maxsimmonds1337/SBS_hw/manufacturing/SBS_hw_schematic.pdf

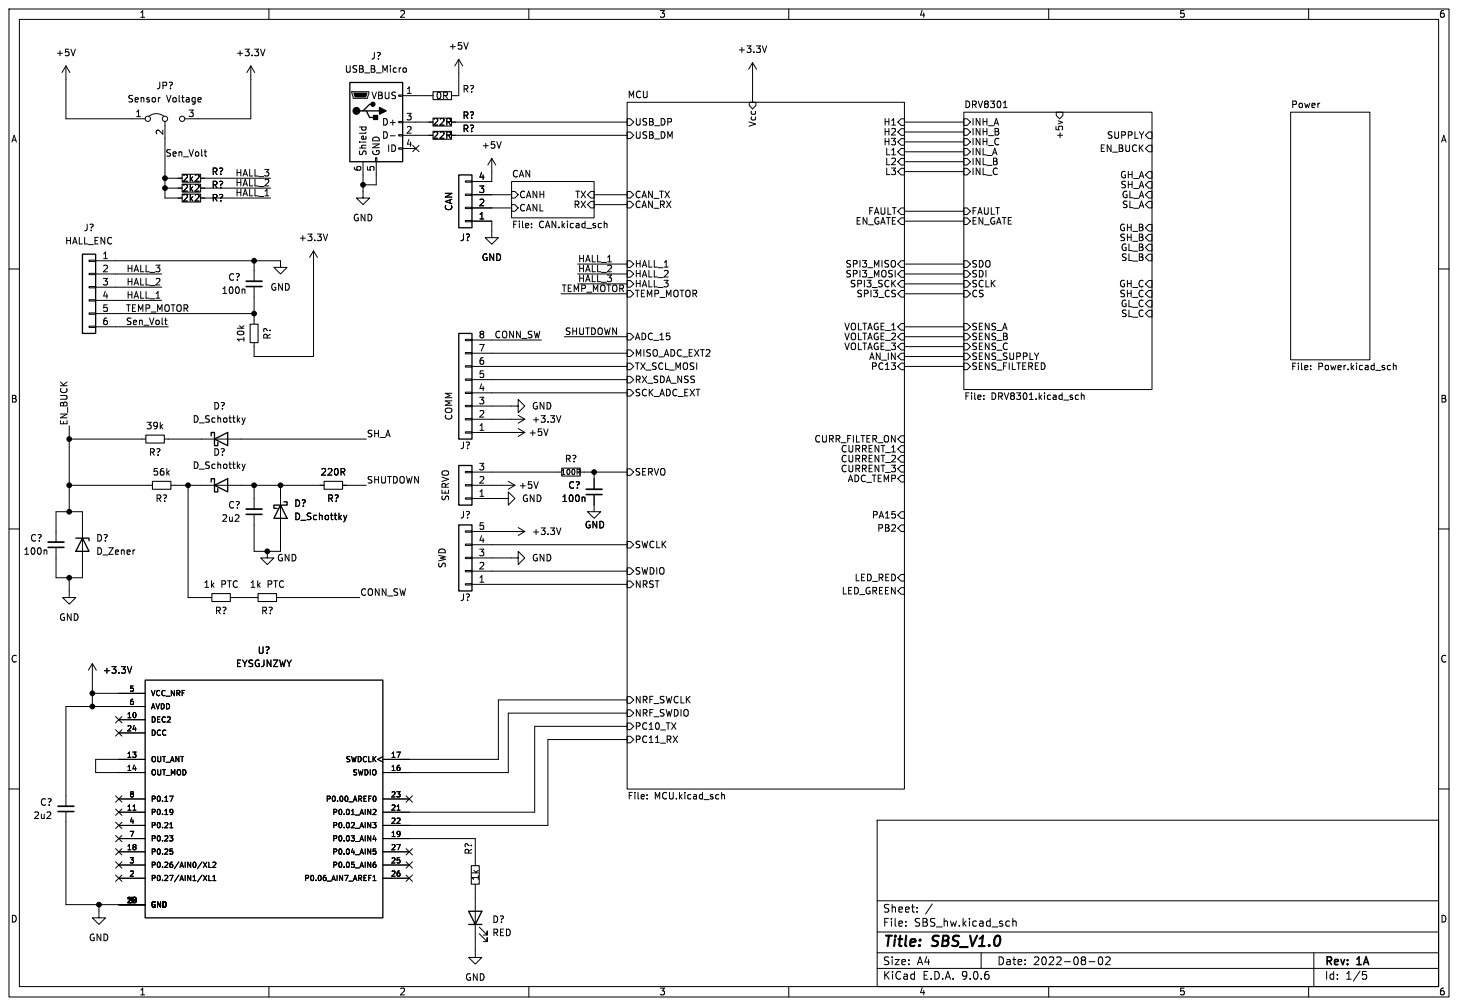
[picture p1: page 1]

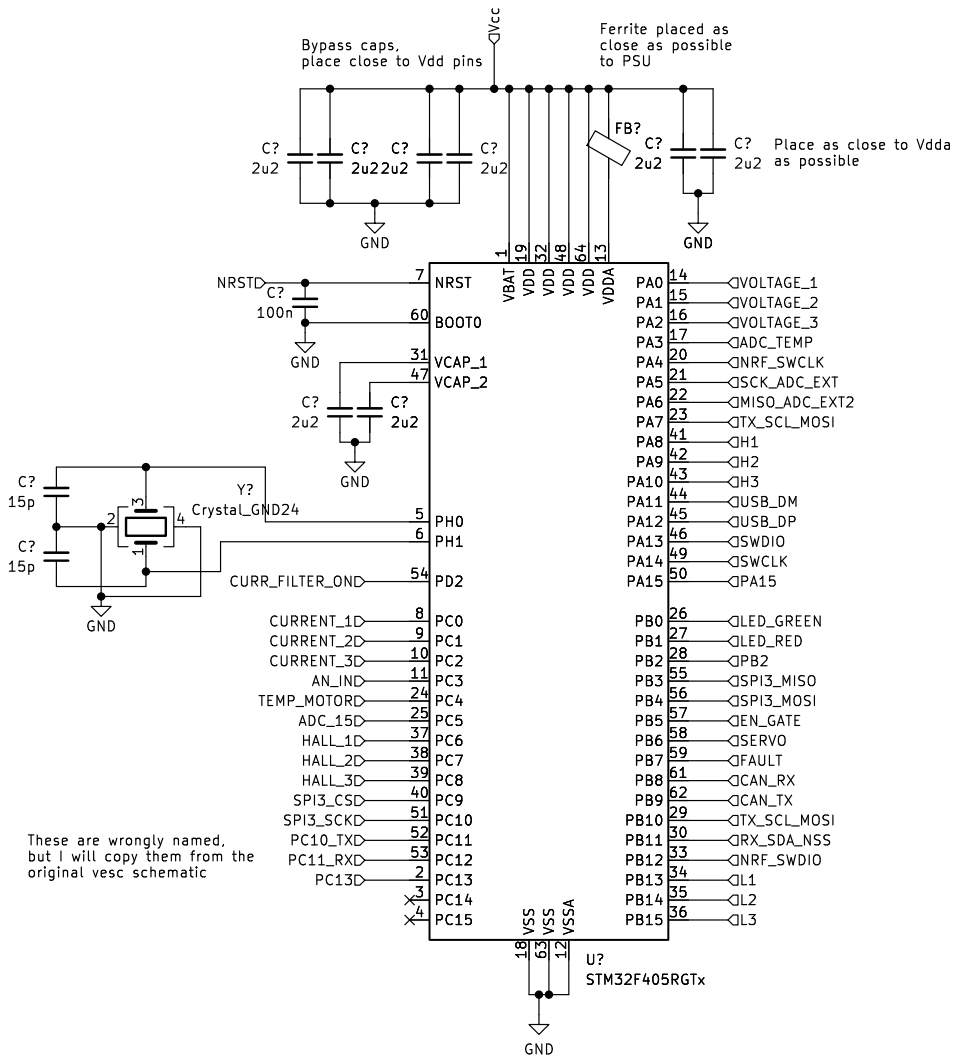
[picture p2: page 2]

Place as close to Vdda

These are wrongly named, but I will copy them from the

Id: 2/5 Title: File: MCU.kicad_sch Sheet: /MCU/

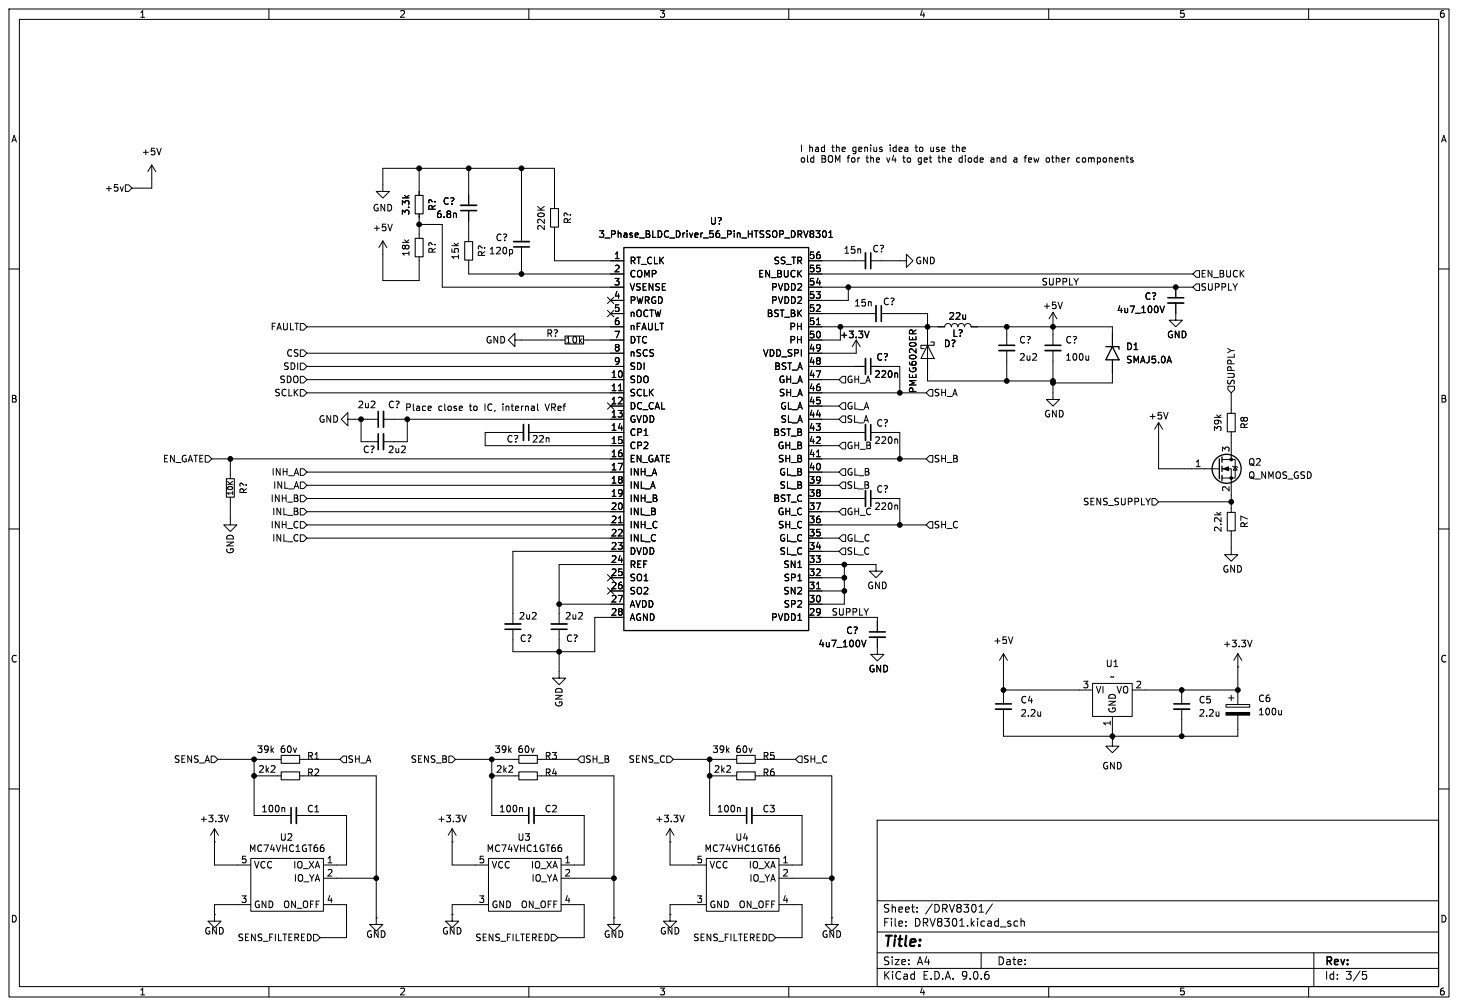
[picture p3: page 3]

I had the genius idea to use the

1 VO 2 U1~ GND GND GND GND

SUPPLY
Id: 3/5 Title: File: DRV8301.kicad_sch Sheet: /DRV8301/ C?

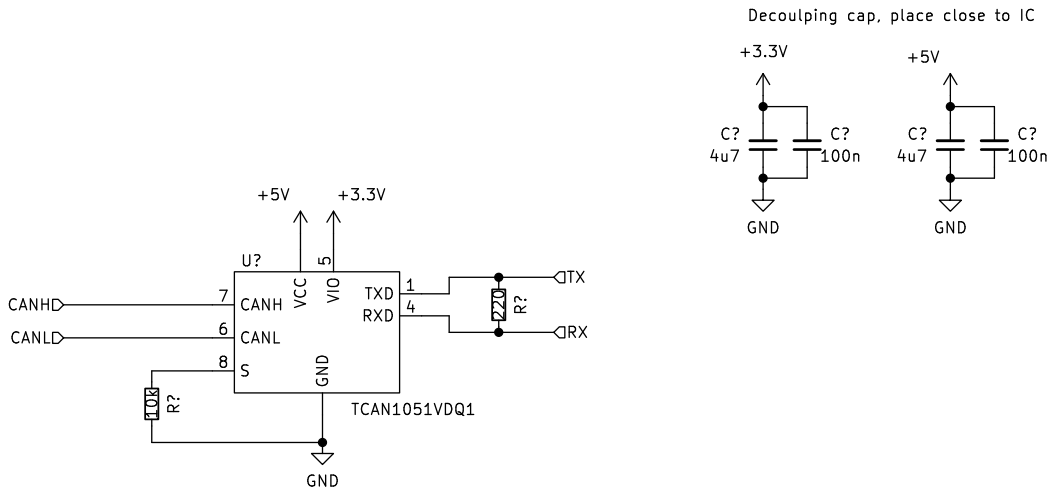
[picture p4: page 4]

Id: 4/5 Title: File: CAN.kicad_sch Sheet: /CAN/

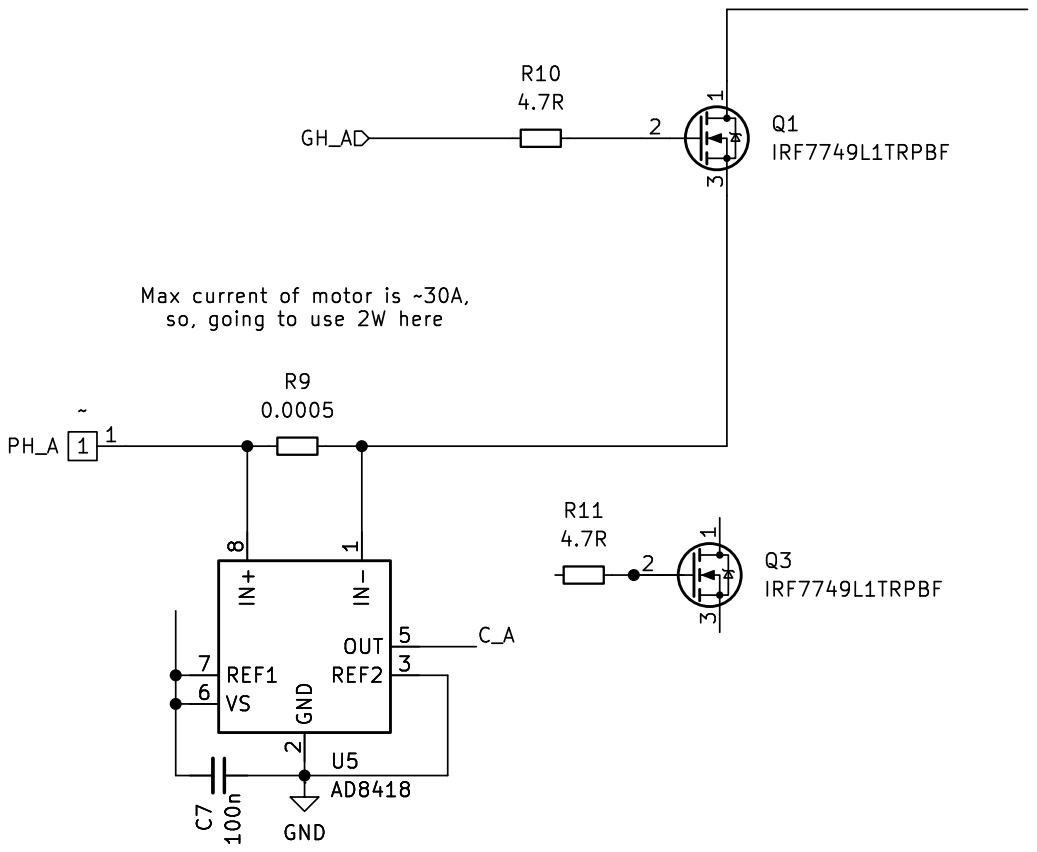
[picture p5: page 5]
