maxsimmonds1337/SBS_hw/simulation/ClosedLoopBuck_PDB.asc

A2: schmtinv; Vhigh=5
A3: and; Vhigh=5
A4: or; Vhigh=5
A6: schmtinv; Vhigh=5
A7: schmtinv; Vhigh=5
C1: cap; 400p
C2: cap; 1n
C3: cap; 10µ
C4: cap; 10µ
C6: cap; 4.55n
C7: cap; 3.18n
C8: cap; 3.18n
C: cap; 100µ; IC=0
D1: diode; 1N914
D2: diode; MMSD4148
L1: ind; 145µ; Ipk=3 Rser=0.09 Rpar=48000 Cpar=3.47p mfg="Gowanda" pn="GT10-105"
M2: nmos; BSC032NE2LS
Q2: pnp; 2N2907
R1: res; 5
R2: res; 2k
R7: res; 7k5
R8: res; 4k3
R9: res; 18.7k
R10: res; 10k
R11: res; 100k
R13: res; 27k
R14: res; 120k
R15: res; 1k
R16: res; 150k
R17: res; 1Meg
R: res; 100k
S1: sw; MYSW
U2: IR2110
U3: OP07
U4: LT1716
U5: NE555
V1: voltage; 12
V2: voltage; 5
V3: voltage; 1.8
V4: voltage; PULSE(5 0 3.5m 1n 1n 20m 40m)
Named nets: HS, 0, LIN, HIN, p5, Vcc, Vout, Vc, saw, Vpwm, Vsence, VS, load, LS
Gate Driver Board
.tran 100m
Dead Time Generator
Saw-Tooth Generator
Main Board Buck Converter
Compensator
PWM modulator
Bootstrap Capacitors
Voltage Sense
.model MYSW SW(Ron=1 Roff=1Meg Vt=.5 Vh=-.4)
R1
R2
C1
C2
