maxsimmonds1337/SBS_hw/design/BMI160.kicad_sch

## KiCad design design/BMI160.kicad_sch (2026-06-29, an earlier design)

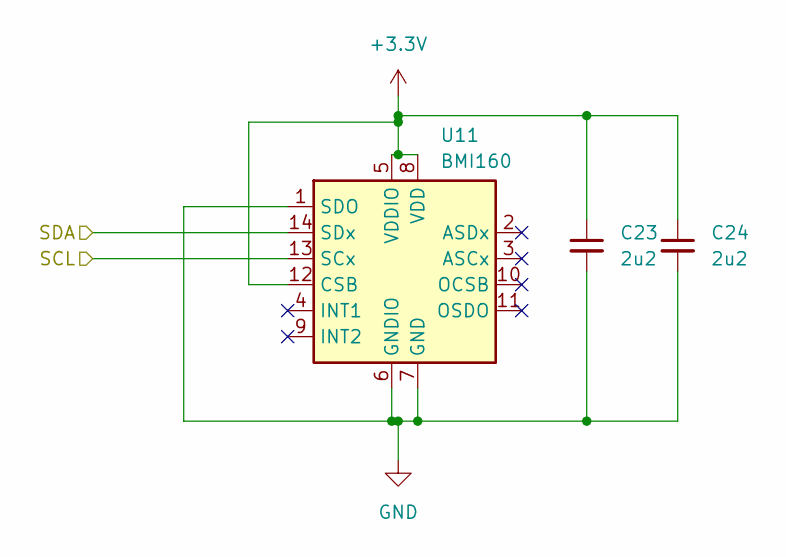
[picture p6: schematic BMI160.kicad_sch]

Parts:
C23, C24: 2u2
U11: BMI160; Bosch_LGA-14_3x2.5mm_P0.5mm

Connections:
+3.3V: C23.1, C24.1, U11.5 (VDDIO), U11.8 (VDD), U11.12 (CSB)
GND: C23.2, C24.2, U11.1 (SDO), U11.6 (GNDIO), U11.7 (GND)
SCL: U11.13 (SCx)
SDA: U11.14 (SDx)
