maxsimmonds1337/SBS_hw/design/Power.kicad_sch

## KiCad design design/Power.kicad_sch (2026-06-30, an earlier design)

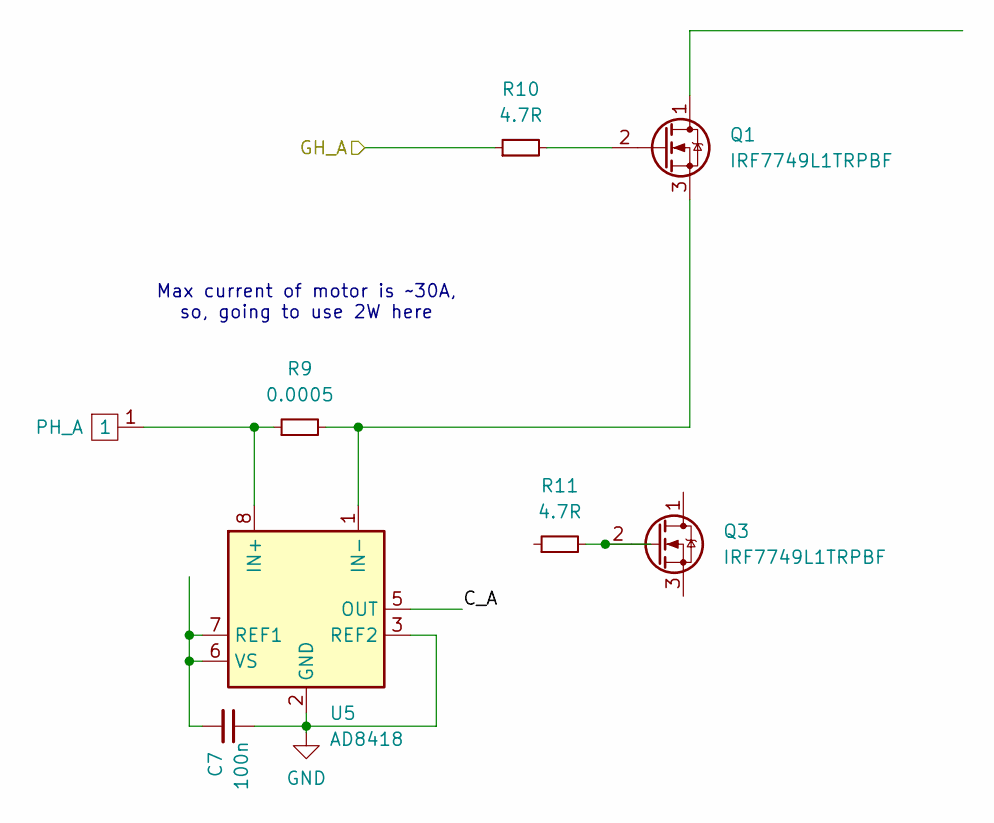
[picture p7: schematic Power.kicad_sch]

Parts:
C7: 100n; C_0603_1608Metric_Pad1.08x0.95mm_HandSolder
PH_A: (no value)
Q1, Q3: IRF7749L1TRPBF; DirectFET_L8
R9: 0.0005
R10, R11: 4.7R; R_0402_1005Metric
U5: AD8418

Connections:
C_A: U5.5 (OUT)
GH_A: R10.1
GND: C7.1, U5.2 (GND), U5.3 (REF2)
unnamed: C7.2, U5.6 (VS), U5.7 (REF1)
unnamed: PH_A.1, R9.1, U5.8 (IN+)
unnamed: Q1.2 (G), R10.2
unnamed: Q1.3 (S), R9.2, U5.1 (IN-)
unnamed: Q3.2 (G), R11.2

Notes on the sheet:
Max current of motor is ~30A, so, going to use 2W here
