maxsimmonds1337/SBS_hw/(commit log)

2021-09-21 added the kicad libs to the template, correctly, as a submodule
2022-08-19 push to work on another laptop
    [SBS_hw.kicad_pcb, SBS_hw.sch, TEOXXXX_boardname.sch]
2023-01-17 pushing from black laptop
    [DRV8301.kicad_sch, MCU.kicad_sch, SBS_hw.kicad_sch]
2023-01-18 reverted back to an older version (more stable) of kicad, so needed to start from an old copy
    [SBS_hw.kicad_sch, USB_OTG.kicad_sch]
2023-01-19 added some connectors:
    [SBS_hw.kicad_sch]
2025-02-21 updates to BLDC
    [CAN.kicad_sch, DRV8301.kicad_sch, MCU.kicad_sch, SBS_hw.kicad_sch]
2025-02-23 more BLDC updates
    [DRV8301.kicad_sch]
2026-06-25 add documentation, manufacturing outputs, and Power sheet WIP
    - Add requirements.md, schematic_review.md, battery_design.md,
    onewheel_system_design.md, vesc_firmware_notes.md
    - Add manufacturing/BOM.md (LCSC parts with costs) and schematic PDF
    - Add design/Power.kicad_sch (Phase A half-bridge WIP)
    - Update DRV8301, top-level and project KiCad files
    - Remove old 2023 backups and accidentally committed linkedin image
    [DRV8301.kicad_sch, Power.kicad_sch, SBS_hw.kicad_sch]
2026-06-25 rewrite schematic_review based on actual KiCad files
    Previous version was reviewed against the VESC 6 MK5 reference PDF,
    not the actual SBS_hw schematic. This version is based on direct
    review of the KiCad sheets and netlist analysis.
    Key findings added: incomplete Power sheet (phases B/C missing),
    CURR_FILTER_ON routing error, EN_BUCK undriven, DRV8301 footprint
    mismatch, BMI160 absent, Q2 unassigned, bootstrap diode voltage issue.
2026-06-26 substitute MC74VHC1GT66 → SN74LVC1G66DCKR on U2/U3/U4
    TI LVC1G66 DCK variant (LCSC C113518) is pin-compatible with the ON Semi
    part: both have pin2=B (signal), pin3=GND in SC-70-5. Update lib_id to
    74xGxx:74LVC1G66, set Value and assign Package_TO_SOT_SMD:SOT-353_SC-70-5
    footprint (was empty) on all three instances. BOM F6 flag resolved.
    [DRV8301.kicad_sch]
2026-06-27 finalised, ish, will have claude review
    [BMI160.kicad_sch, CAN.kicad_sch, DRV8301.kicad_sch, MCU.kicad_sch, Power.kicad_sch, SBS_hw.kicad_sch]
2026-06-27 Sheet 1 (SBS_hw.kicad_sch): assign footprints and part values
    - LEDs D2/D3/D4: footprint LED_SMD:LED_0603_1608Metric, values LED_RED/GREEN/BLUE
    - LED D?: footprint LED_SMD:LED_0603_1608Metric
    - Zener D?: value BZX84C3V6, footprint Diode_SMD:D_SOT-23
    - Schottky D? ×3: value 1N5819WS, footprint Diode_SMD:D_SOD-323
    - USB J?: footprint Connector_USB:USB_Micro-B_Molex_105017-0001
    - SERVO J?: footprint Connector_JST:JST_PH_S3B-PH-K 2mm horizontal
    - HALL_ENC J?: footprint Connector_JST:JST_PH_S6B-PH-K 2mm horizontal
    - COMM J?: footprint Connector_PinHeader_2.54mm 1x08
    - SWD J?: footprint Connector_PinHeader_1.27mm 1x05
    - CAN J?: footprint Connector_JST:JST_PH_S4B-PH-K 2mm horizontal
    - Sensor Volta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
    [SBS_hw.kicad_sch]
2026-06-27 Sheet 2 (MCU.kicad_sch): fix crystal; document BOOT0/PC13 and VDDA issues
    Crystal Y? (MC-007 RESOLVED):
    - Value: Crystal_GND24 → 8MHz
    - Footprint: → Crystal:Crystal_SMD_3225-4Pin_3.2x2.5mm
    (matches LCSC C5181477 SOSET 8MHz 20pF 10ppm per BOM.md)
    New issues found via direct coordinate analysis (both need KiCad wiring fixes):
    - MC-013: PC13 hierarchical label placed at BOOT0 pin (y=133.35) not PC13 GPIO (y=62.23)
    - MC-015: VDDA (pin 13) has no wire connection; needs +3.3V path and bypass caps
    [MCU.kicad_sch]
2026-06-27 Sheet 3 (DRV8301.kicad_sch): assign footprints, update parts, fix issues
    MC-002 partial: BST_A D? PMEG6020ER → DSS210 (100V, SOD-123F). BST_B/C still need placement in KiCad.
    MC-004 resolved: DRV8301 U? footprint set to Texas_HTSSOP-56_6.1x9.7mm_P0.65mm.
    MC-006 resolved: TC2117 U1 Value set (was ~), Footprint SOT-223-3_TabPin2.
    MC-008 resolved: Q2 SENS_SUPPLY assigned BSS138 / SOT-23.
    MC-014 partial: U2/U3/U4 Value → SN74LVC1G66DCKR, Footprint → SOT-353_SC-70-5 (lib_id kept compatible).
    Blank footprints filled in: C1/C2/C3 (100n 0603), C4/C5 (2.2u 0805), C6 (100u elec), R1-R6 (0603), L? (1008).
    [DRV8301.kicad_sch]
2026-06-27 Sheets 4–6: fix remaining blank footprints, update analog switches
    CAN sheet (Sheet 4): already clean, no changes.
    BMI160 sheet (Sheet 5):
    - C23, C24 (2u2): footprint set to C_0603 HandSolder
    Power sheet (Sheet 6):
    - U8/U9/U10: Value → SN74LVC1G66DCKR, Footprint → SOT-353_SC-70-5 (MC-014 partial)
    - U5/U6/U7 AD8418: Footprint → MSOP-8_3x3mm_P0.65mm
    - R9/R13/R16 shunt (0.5mΩ): Footprint → R_2010_5025Metric
    - J1/J2, PH_A/B/C: placeholder PinHeader_1x01 footprints
    - TH1, R18-R21: R_0603 HandSolder
    - C16-C22 (1n/15n/2u2): C_0603 HandSolder
    [BMI160.kicad_sch, Power.kicad_sch]
2026-06-27 L? inductor: assign SMNR4020-22UH (LCSC C135264)
    22µH ±20%, 1.05A Isat, 455mΩ DCR, 4×4×2mm SMD.
    Footprint corrected from L_1008_2520Metric → L_4040_Coilcraft_DO3316.
    LCSC property added to schematic symbol.
    BOM.md updated with selected part.
    [DRV8301.kicad_sch]
2026-06-29 All sheets: add LCSC part numbers to 136 components
    Populated LCSC Cxxxxxx properties on every assigned component across all
    6 sheets (SBS_hw, MCU, DRV8301, CAN, BMI160, Power). Remaining ~19
    components (15nF/120pF 0603 caps, 2.2µF 0805, 100µF electrolytic/1210,
    1k PTC, 1.27mm SWD header, solder jumper, single-pin placeholders) have
    no confirmed LCSC number and are left unpopulated.
    Claude-Session: https://claude.ai/code/session_01DS1NowMbUxuJRBVhV127qS
    [BMI160.kicad_sch, CAN.kicad_sch, DRV8301.kicad_sch, MCU.kicad_sch, Power.kicad_sch, SBS_hw.kicad_sch]
2026-06-29 Add root CLAUDE.md briefing; update ISSUES.md resolved items
    CLAUDE.md captures full project context, workflow rules, LCSC workflow,
    current open/resolved status, and quick-reference part table — intended
    as the entry point for future Claude sessions.
    ISSUES.md: MC-001/006/008 marked fully resolved after LCSC property
    population (commit 9ac1957).
    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
2026-06-30 schematic basicaly done. mechanical design fleshed out
    [DRV8301.kicad_sch, Power.kicad_sch]
